illar47/integratedDesignProject/notes_and_documentation/IMG_1744.jpg

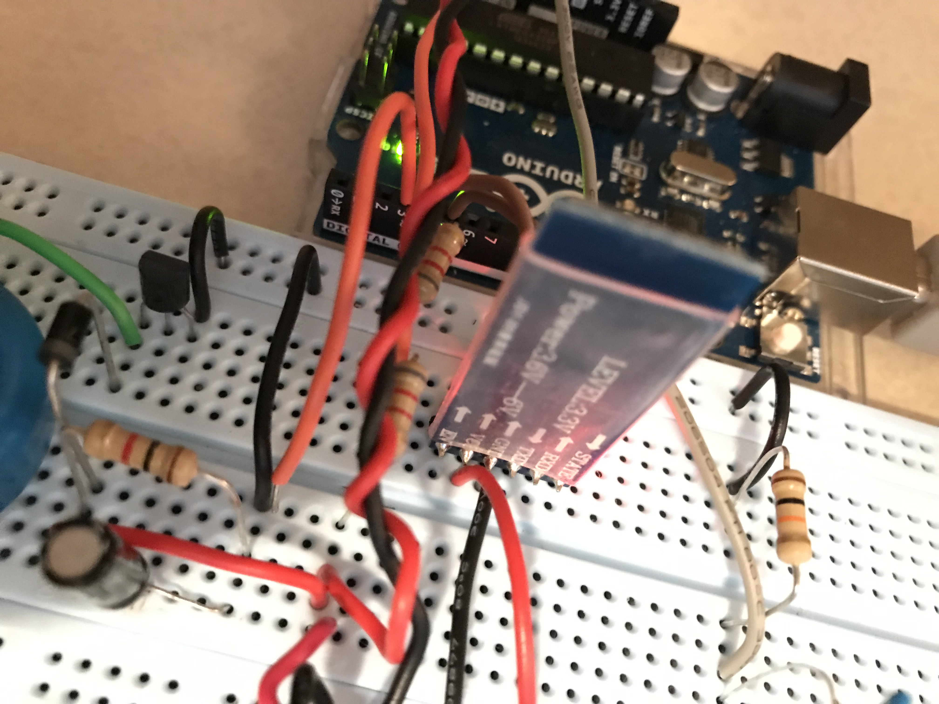
notes_and_documentation/IMG_1744.jpg
