illar47/integratedDesignProject/notes_and_documentation/IMG_1743.jpg

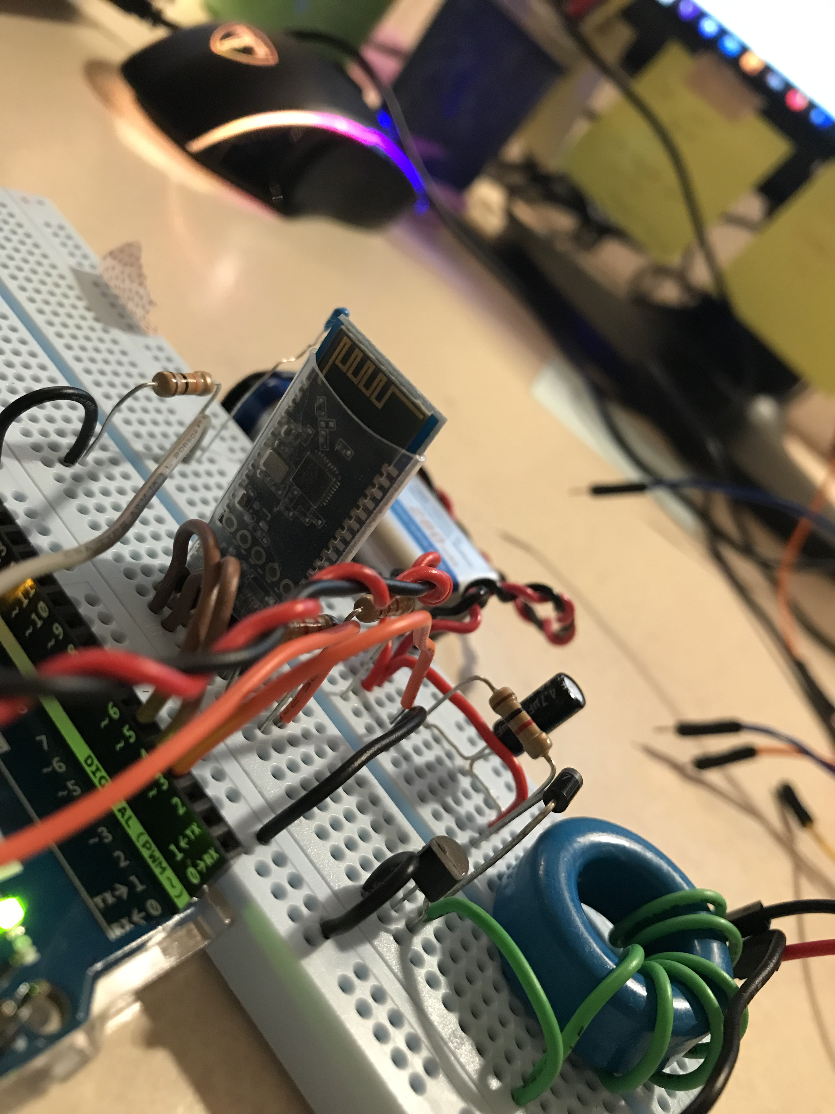
notes_and_documentation/IMG_1743.jpg
