illar47/integratedDesignProject/notes_and_documentation/calculations.docx

Inductor Value

∆i_L =(V_(in))/(2L)DT_s

L=(V_(in))/(2∆i_L)DT_s =5/(2×100×10^(-3))(0.5)(1/(32×10^3))=390.625 µH

Capacitor Value

∆V=(V_(out))/(2RC)DT_s

C=(V_(out))/(2R∆V)DT_s =9/(2×1.5×10^3 ×0.003×5)(0.5)(1/(32×10^3))=3.125 µF
