illar47/integratedDesignProject/misc/IMG_1693.jpg

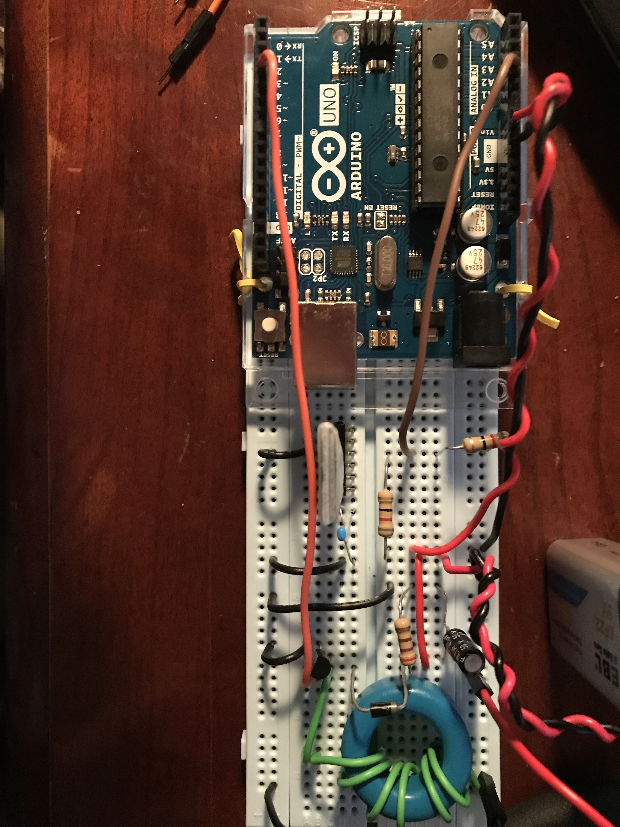
misc/IMG_1693.jpg
