illar47/integratedDesignProject/notes_and_documentation/IMG_1742.jpg

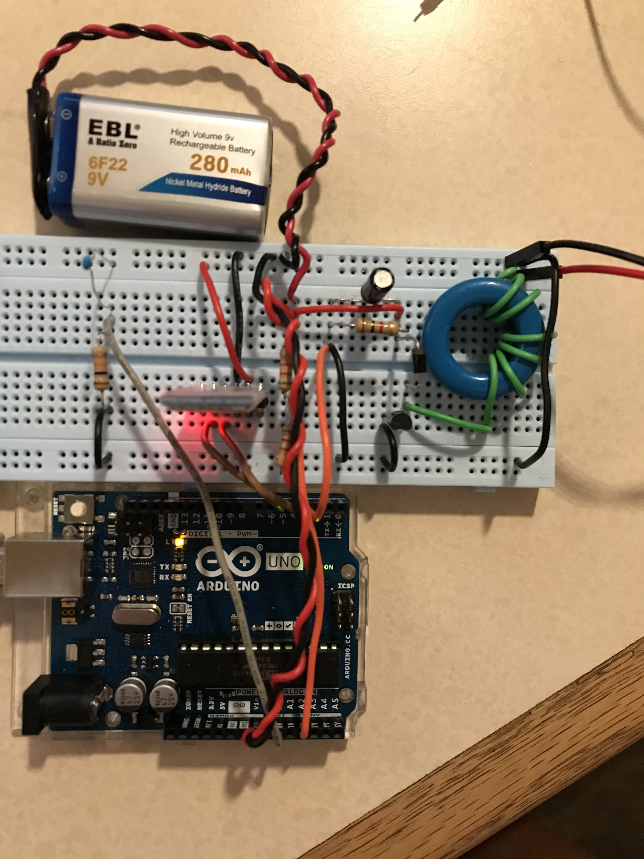
notes_and_documentation/IMG_1742.jpg
