illar47/integratedDesignProject/notes_and_documentation/IMG_1745.jpg

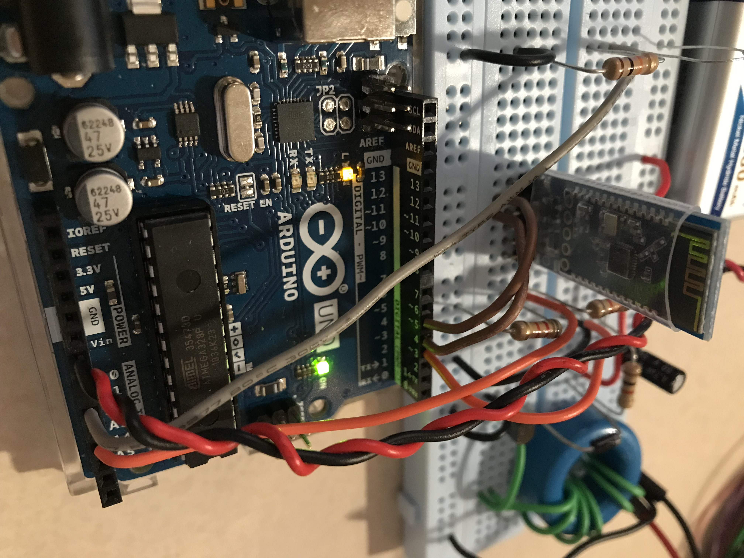
notes_and_documentation/IMG_1745.jpg
