illar47/integratedDesignProject/notes_and_documentation/IMG_1746.jpg

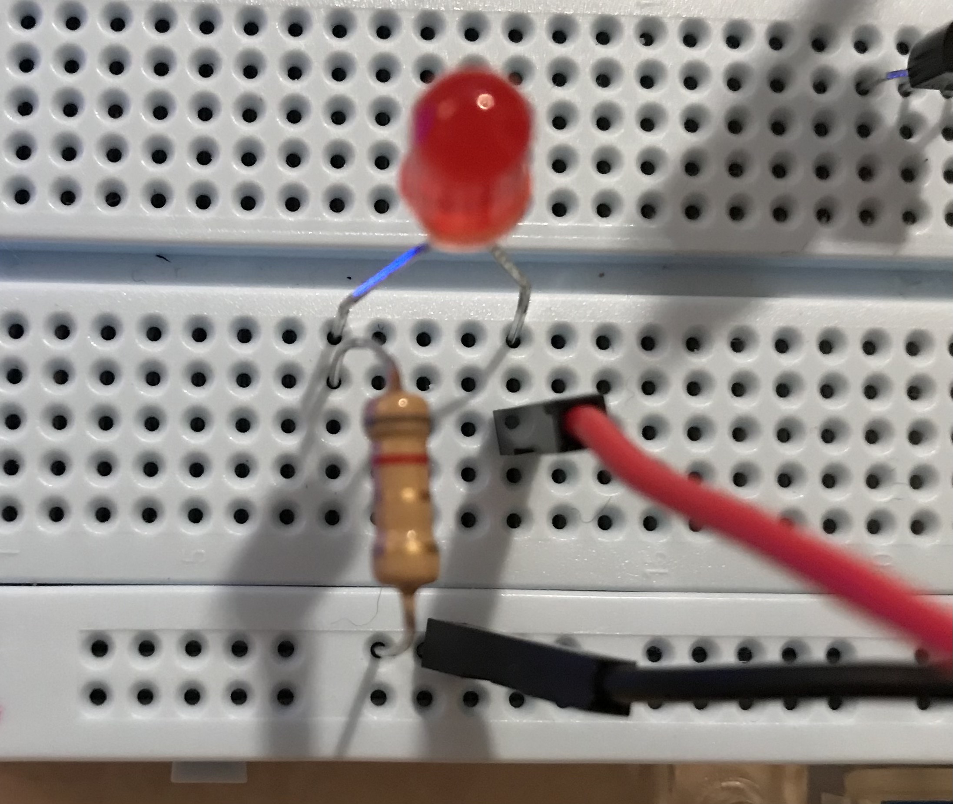
notes_and_documentation/IMG_1746.jpg
