illar47/integratedDesignProject/optimalLoadTest.xlsx

Sheet: newOpLoad
Rload | Efficiency
0 | 0.6383227821
50 | 0.6383227821
100 | 0.7473505663
200 | 0.8004292869
300 | 0.7918548205
400 | 0.7772089381
500 | 0.7656050549
600 | 0.7525434854
700 | 0.739038213
800 | 0.7307866106
900 | 0.7879977166
1000 | 0.7085011584
1100 | 0.6987842497
1200 | 0.6833034111
1300 | 0.6770437956
1400 | 0.6646426028
1500 | 0.6597938144
1600 | 0.6491815616
1700 | 0.6383002663
1800 | 0.629674261

Sheet: optimal load
Value of R Load | Power transfer | Value of R Load | Efficency
0 | 0 | 0 | 0.03320951129
20 | 0.003016170938 | 20 | 0.03157820522 | source resistance | 387.1524258
40 | 0.005480677478 | 40 | 0.03009966017
60 | 0.007502052115 | 60 | 0.0287533783
80 | 0.00916458448 | 80 | 0.02752237203
100 | 0.01053441128 | 100 | 0.02639244347
120 | 0.01166391216 | 120 | 0.02535163435
140 | 0.01259492616 | 140 | 0.02438980118
160 | 0.01336113442 | 160 | 0.02349828357
180 | 0.01398984574 | 180 | 0.02266964271
200 | 0.01450334859 | 200 | 0.02189745336
220 | 0.01491994494 | 220 | 0.02117613685
240 | 0.01525474799 | 240 | 0.02050082616
260 | 0.01552030279 | 260 | 0.01986725591
280 | 0.01572707294 | 280 | 0.0192716722
300 | 0.01588382507 | 300 | 0.01871075816
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
