illar47/integratedDesignProject/proj_schematic.asc

C1: cap
D1: diode
L1: ind
M1: nmos
R1: res
V1: voltage
Named nets: 0
