illar47/integratedDesignProject/review_files/review_amps.asc

Rf: res; 100K
Ri: res; 5.6K
U1: opamp2; LF356
U2: opamp2; LF356
Vcc: voltage; 5
Vee: voltage; -5
Vin: voltage; SINE(0 0.1 1K)
Named nets: 0, Vout
Illa Rochez ECE 2804 Review Lab
.tran 0 0.005 0
.include C:\\Users\\iroch\\OneDrive\\Documents\\LTspiceXVII\\lib\\sub\\LF356.sub
.include C:\\Users\\iroch\\OneDrive\\Documents\\LTspiceXVII\\lib\\sub\\LF356.sub
