illar47/integratedDesignProject/review_files/review_amps_complicated.asc

R1: res; 82K
R2: res; 47K
R3: res; 330K
Rf: res; 100K
U1: opamp2; LF356
V1: voltage; SINE(0 0.5 1K)
Vcc: voltage; 5
Vee: voltage; -5
Named nets: 0, Vout
.include C:\\Users\\iroch\\OneDrive\\Documents\\LTspiceXVII\\lib\\sub\\LF356.sub
Illa Rochez ECE 2804 Review Lab
.tran 0 0.005 0
