illar47/integratedDesignProject/review_files/review_filter_highPass.asc

C1: polcap; 0.001µ; V=16 Irms=0 Rser=11 Lser=0
R1: res; 3.3K
V1: voltage; ""; AC 1
Named nets: Vout, 0
Review Assignment ECE 2804 Illa Rochez
.ac list 1000 100 1meg
